isaacllimona/glowie/pcb/panel/glowie_panel.kicad_pcb

## KiCad design pcb/panel/glowie_panel.kicad_pcb (2026-10-28)

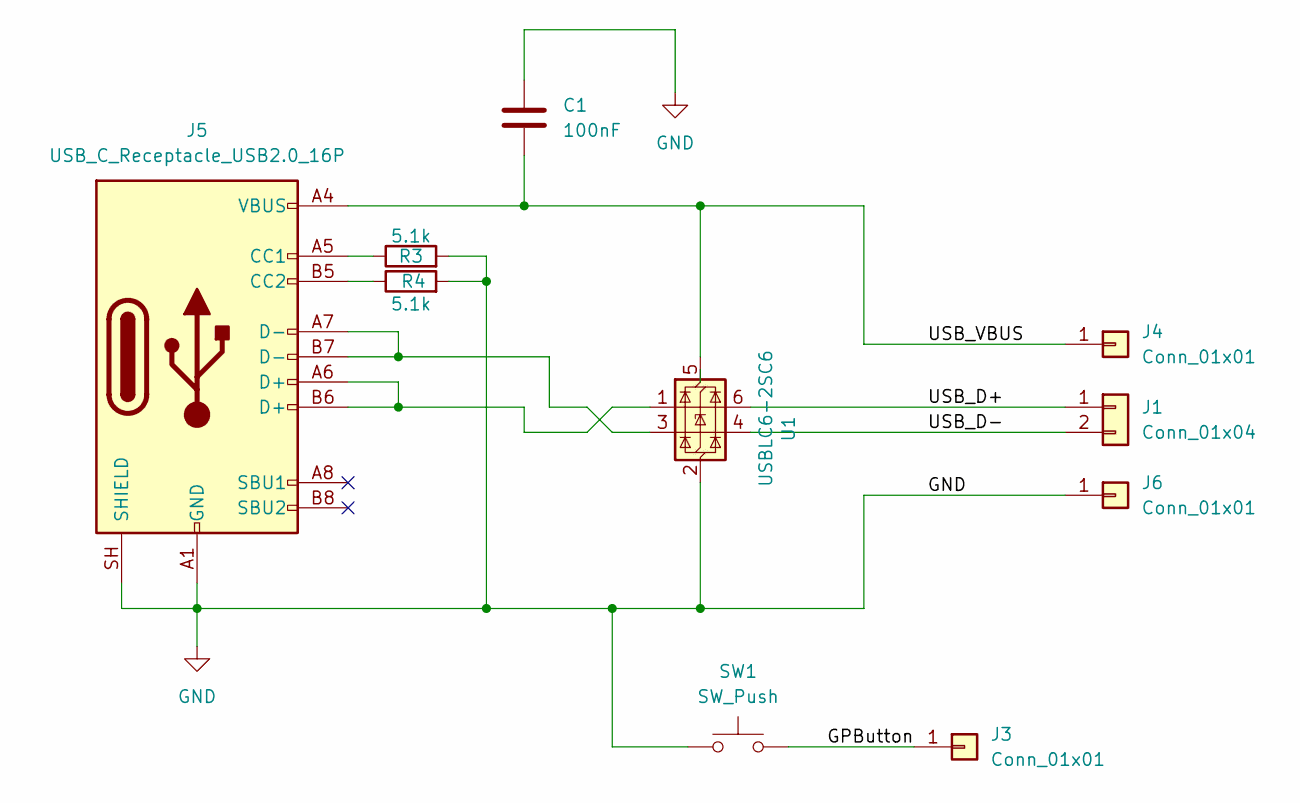
[picture p1: schematic glowie_panel.kicad_sch]

Parts:
C1: 100nF; C_0402_1005Metric
J1: Conn_01x04; usb_data_wire_pads
J3: Conn_01x01; SolderWirePad_1x01_SMD_1.5x3mm
J4, J6: Conn_01x01; th_wire_pad_0.9mm
J5: USB_C_Receptacle_USB2.0_16P; CONN_USB4145-03-0230-C_GCT; MPN USB4220-03-1000-C
R3, R4: 5.1k; R_0402_1005Metric; MPN 0402 5.1k
SW1: SW_Push; TACT_PTS815; MPN PTS815 SJG 250 SMTR LFS
U1: USBLC6-2SC6; SOT-23-6; MPN USBLC6-2SC6

Connections:
/GPButton: J3.1 (Pin_1_1), SW1.2
/USB_D+: J1.1, U1.6 (I/O1)
/USB_D-: J1.2, U1.4 (I/O2)
/USB_VBUS: C1.2, J4.1 (Pin_1_1), J5.A4 (VBUS), J5.A9 (VBUS), J5.B4 (VBUS), J5.B9 (VBUS), U1.5 (VBUS)
GND: C1.1, J5.A1 (GND), J5.A12 (GND), J5.B1 (GND), J5.B12 (GND), J5.SH (SHIELD), J6.1 (Pin_1_1), R3.2, R4.2, SW1.1, U1.2 (GND)
unnamed: J5.A5 (CC1), R3.1
unnamed: J5.B5 (CC2), R4.1
unnamed: J5.A6 (D+), J5.B6 (D+), U1.1 (I/O1)
unnamed: J5.A7 (D-), J5.B7 (D-), U1.3 (I/O2)

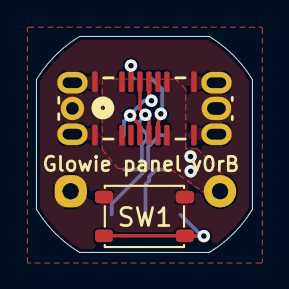
[picture p2: board glowie_panel.kicad_pcb from above]

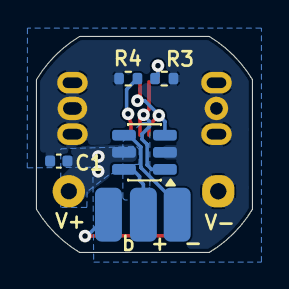
[picture p3: board glowie_panel.kicad_pcb from below]

Board: 2 copper layers, 12.0 x 12.0 mm, 10 parts (8 on the bottom side), 9 nets.
