isaacllimona/glowie/pcb/mainboard/glowie.kicad_pcb

## KiCad design pcb/mainboard/glowie.kicad_pcb (2026-09-04)

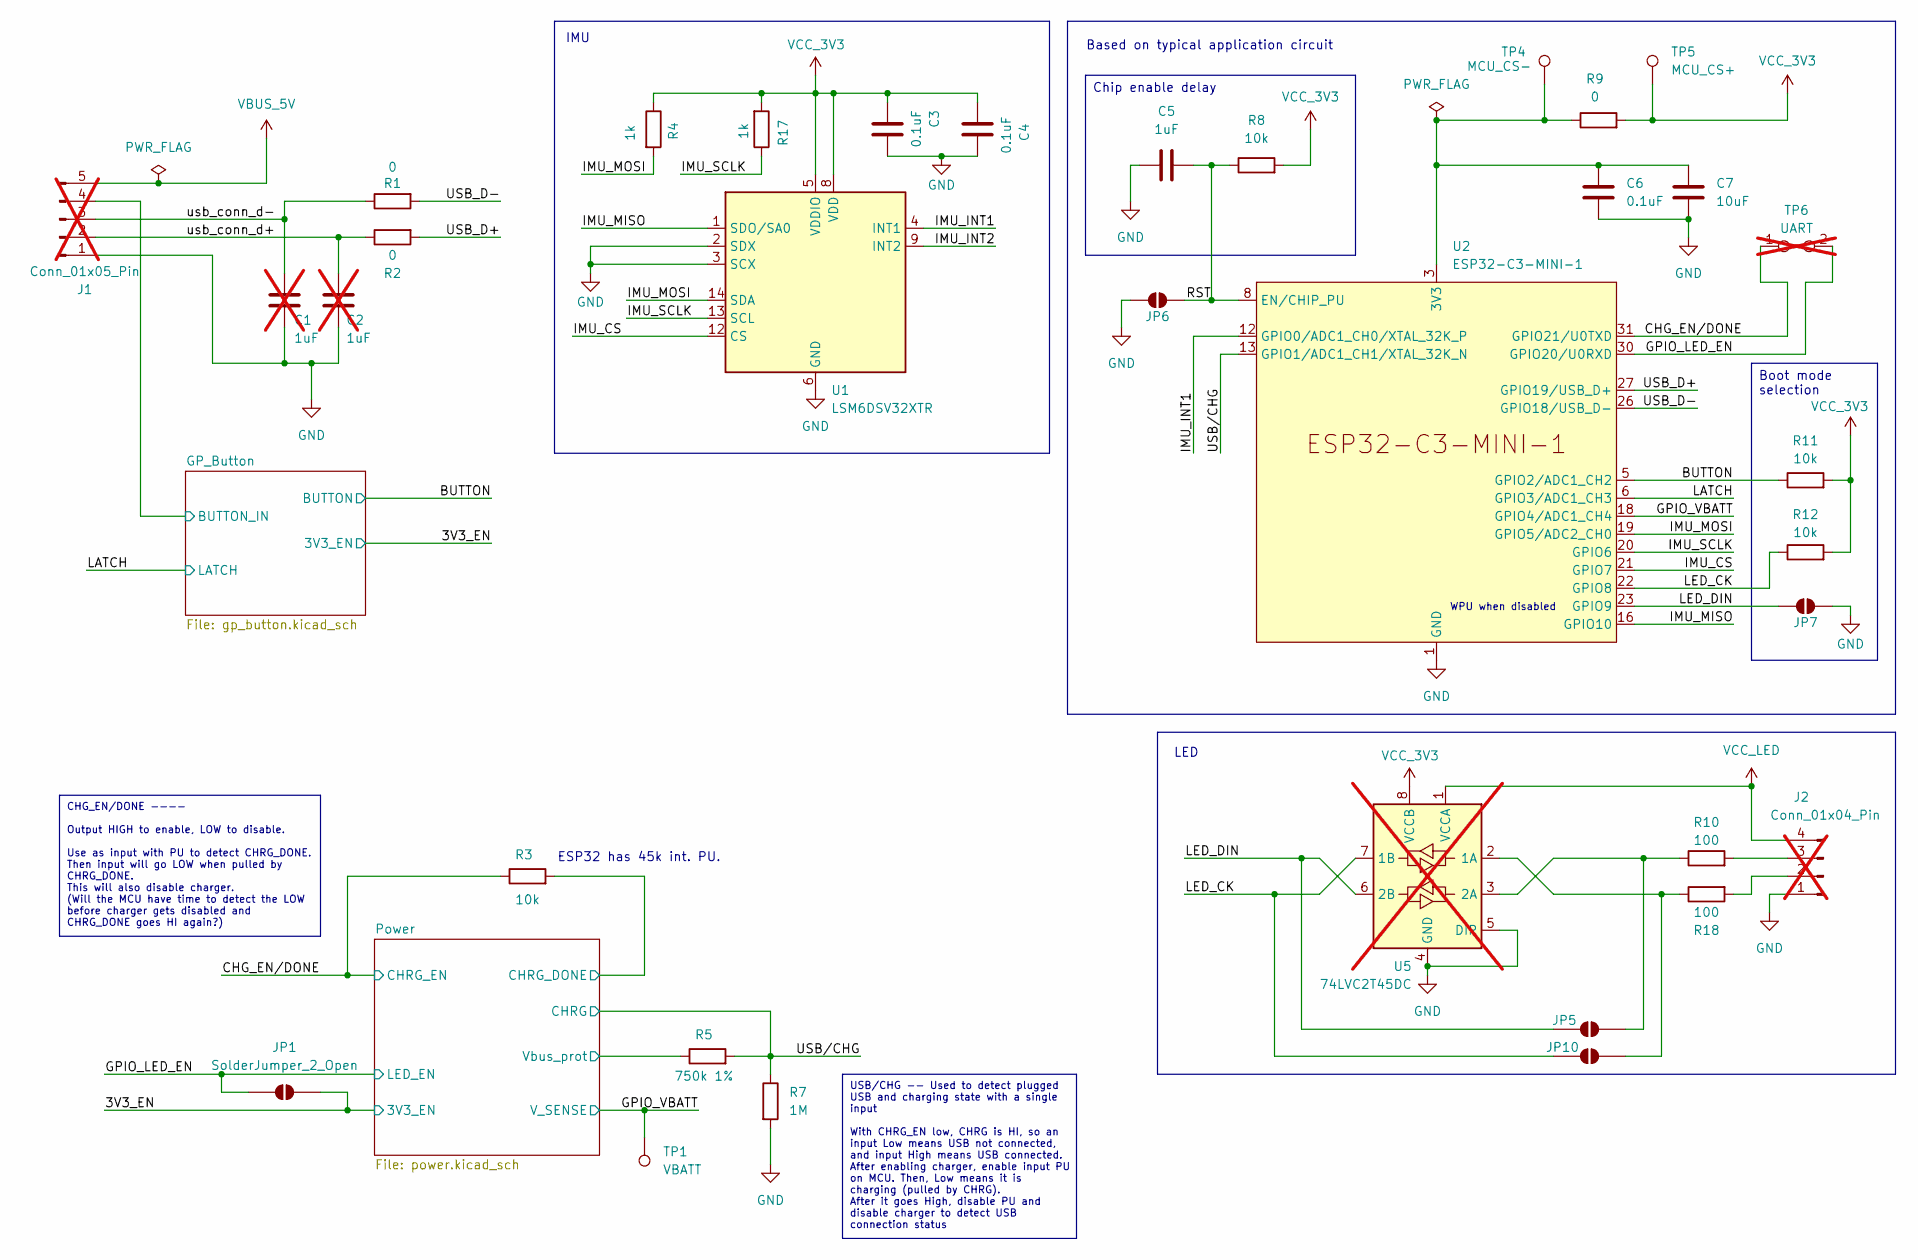
[picture p4: schematic glowie.kicad_sch]

Parts:
C1, C2: 1uF; C_0402_1005Metric; not fitted
C3, C4, C6: 0.1uF; C_0402_1005Metric
C5: 1uF; C_0402_1005Metric
C7: 10uF; C_0402_1005Metric
J1: Conn_01x05_Pin; PinHeader_1x05_P2.00mm_Vertical; not fitted
J2: Conn_01x04_Pin; PinHeader_1x04_P2.00mm_Vertical; not fitted
JP1, JP5, JP10: SolderJumper_2_Open; SolderJumper
JP6, JP7: SolderJumper_2_Open; SolderJumper-2_P1.3mm_Open_RoundedPad1.0x1.5mm
R1, R2: 0; R_0402_1005Metric; MPN 0402 33
R3, R8, R11, R12: 10k; R_0402_1005Metric; MPN 0402 10k
R4, R17: 1k; R_0402_1005Metric_Pad0.72x0.64mm_HandSolder; MPN 0402 1k
R5: 750k 1%; R_0402_1005Metric; MPN 0402 750k
R7: 1M; R_0402_1005Metric; MPN 0402 1M
R9: 0; R_0402_1005Metric_Pad0.72x0.64mm_HandSolder; MPN 0402 10k
R10, R18: 100; R_0402_1005Metric
TP1: VBATT; TestPoint_Pad_D1.0mm
TP4: MCU_CS-; TestPoint_Pad_D1.0mm
TP5: MCU_CS+; TestPoint_Pad_D1.0mm
TP6: UART; PinHeader_1x02_P2.00mm_Vertical; not fitted
U1: LSM6DSV32XTR; LGA-14_3x2.5mm_P0.5mm_LayoutBorder3x4y; MPN LSM6DSV32XTR
U2: ESP32-C3-MINI-1; MPN ESP32-C3-MINI-1
U5: 74LVC2T45DC; VSSOP-8_2.3x2mm_P0.5mm; not fitted

Connections:
/3V3_EN: JP1.1 (A); also elsewhere on the board
/BUTTON: R11.1, U2.5 (GPIO2/ADC1_CH2); also elsewhere on the board
/CHG_EN/DONE: R3.1, TP6.1, U2.31 (GPIO21/U0TXD); also elsewhere on the board
/GPIO_LED_EN: JP1.2 (B), TP6.2, U2.30 (GPIO20/U0RXD); also elsewhere on the board
/GPIO_VBATT: TP1.1 (1_1), U2.18 (GPIO4/ADC1_CH4); also elsewhere on the board
/GP_Button/BUTTON_IN: J1.4; also elsewhere on the board
/IMU_CS: U1.12 (CS), U2.21 (GPIO7)
/IMU_INT1: U1.4 (INT1), U2.12 (GPIO0/ADC1_CH0/XTAL_32K_P)
/IMU_INT2: U1.9 (INT2)
/IMU_MISO: U1.1 (SDO/SA0), U2.16 (GPIO10)
/IMU_MOSI: R4.2, U1.14 (SDA), U2.19 (GPIO5/ADC2_CH0)
/IMU_SCLK: R17.1, U1.13 (SCL), U2.20 (GPIO6)
/LATCH: U2.6 (GPIO3/ADC1_CH3); also elsewhere on the board
/LED_CK: JP10.1 (A), R12.1, U2.22 (GPIO8), U5.7 (1B)
/LED_DIN: JP5.1 (A), JP7.1 (A), U2.23 (GPIO9), U5.6 (2B)
/Power/CHRG_DONE: R3.2; also elsewhere on the board
/Power/Vbus_prot: R5.1; also elsewhere on the board
/RST: C5.2, JP6.2 (B), R8.1, U2.8 (EN/CHIP_PU)
/USB_D+: R2.2, U2.27 (GPIO19/USB_D+)
/USB_D-: R1.2, U2.26 (GPIO18/USB_D-)
/USB/CHG: R5.2, R7.1, U2.13 (GPIO1/ADC1_CH1/XTAL_32K_N); also elsewhere on the board
/usb_conn_d+: C2.2, J1.2, R2.1
/usb_conn_d-: C1.2, J1.3, R1.1
GND: C1.1, C2.1, C3.1, C4.2, C5.1, C6.2, C7.2, J1.1, J2.1, JP6.1 (A), JP7.2 (B), R7.2, U1.2 (SDX), U1.3 (SCX), U1.6 (GND), U1.7 (GND), U2.1 (GND), U2.2 (GND), U2.11 (GND), U2.14 (GND), U2.36 (GND), U2.37 (GND), U2.38 (GND), U2.39 (GND), U2.40 (GND), U2.41 (GND), U2.42 (GND), U2.43 (GND), U2.44 (GND), U2.45 (GND), U2.46 (GND), U2.47 (GND), U2.48 (GND), U2.49 (GND), U2.50 (GND), U2.51 (GND), U2.52 (GND), U2.53 (GND), U5.4 (GND), U5.5 (DIR); also elsewhere on the board
unnamed: J2.2, R18.2
unnamed: J2.3, R10.2
unnamed: JP5.2 (B), R10.1, U5.3 (2A)
unnamed: JP10.2 (B), R18.1, U5.2 (1A)
unnamed: C6.1, C7.1, R9.1, TP4.1 (1_1), U2.3 (3V3)
VBUS_5V: J1.5; also elsewhere on the board
VCC_3V3: C3.2, C4.1, R4.1, R8.2, R9.2, R11.2, R12.2, R17.2, TP5.1 (1_1), U1.5 (VDDIO), U1.8 (VDD), U5.8 (VCCB); also elsewhere on the board
VCC_LED: J2.4, U5.1 (VCCA); also elsewhere on the board

Notes on the sheet:
WPU when disabled
IMU
Based on typical application circuit
LED
ESP32 has 45k int. PU.
Boot mode selection
Chip enable delay
USB/CHG -- Used to detect plugged USB and charging state with a single input With CHRG_EN low, CHRG is HI, so an input Low means USB not connected, and input High means USB connected. After enabling charger, enable input PU on MCU. Then, Low means it is charging (pulled by CHRG). After it goes High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
CHG_EN/DONE ---- Output HIGH to enable, LOW to disable. Use as input with PU to detect CHRG_DONE. Then input will go LOW when pulled by CHRG_DONE. This will also disable charger. (Will the MCU have time to detect the LOW before charger gets disabled and CHRG_DONE goes HI again?)

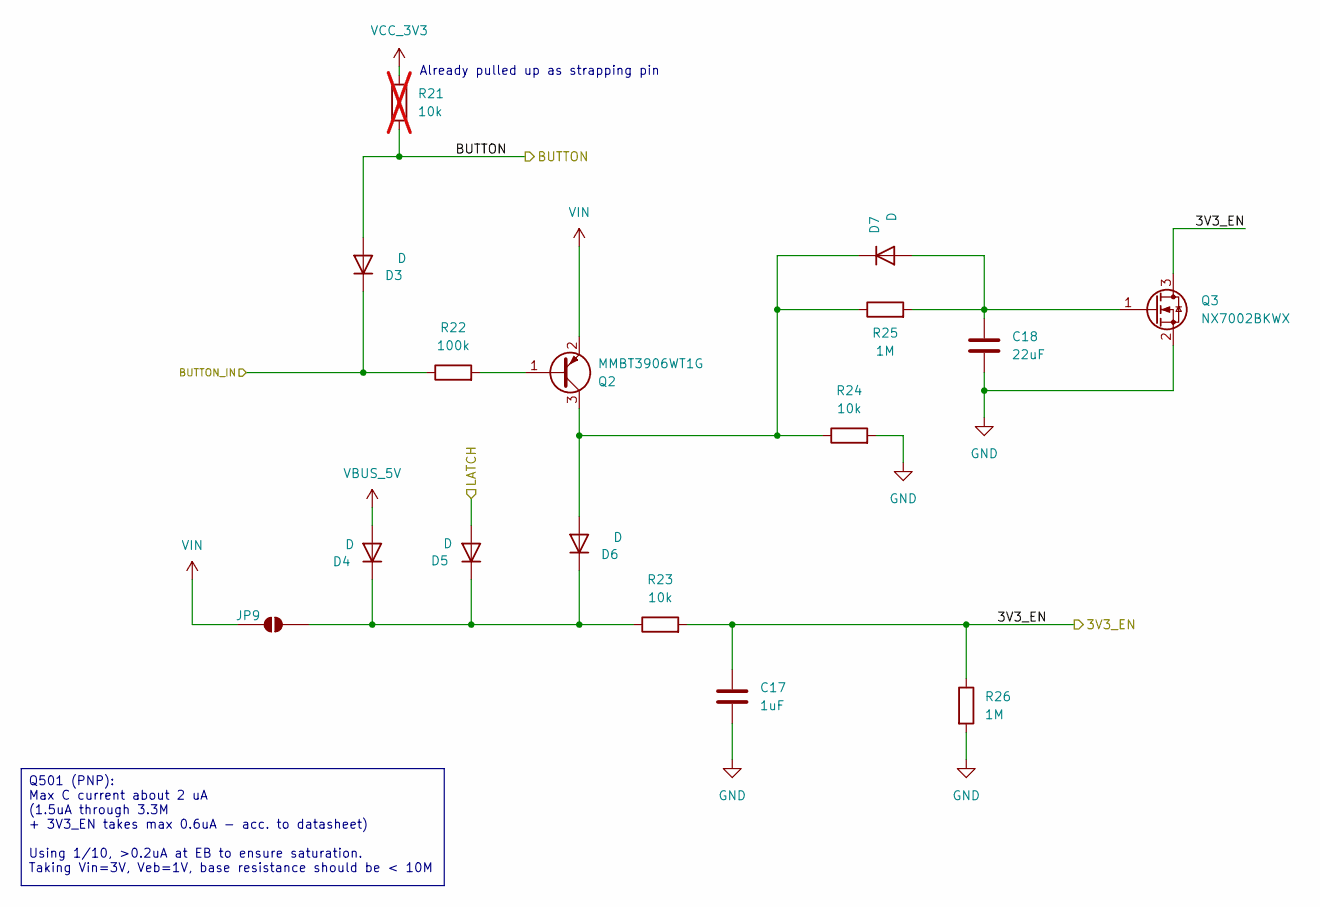
[picture p5: schematic gp_button.kicad_sch]

Parts:
C17: 1uF; C_0402_1005Metric_Pad0.74x0.62mm_HandSolder
C18: 22uF; C_0603_1608Metric
D3, D4, D5, D6, D7: D; D_SOD-882D; MPN 0402
JP9: SolderJumper_2_Open; SolderJumper
Q2: MMBT3906WT1G; SOT-323_SC-70; MPN MMBT3906WT1G
Q3: NX7002BKWX; SOT-323_SC-70
R21: 10k; R_0402_1005Metric; not fitted
R22: 100k; R_0402_1005Metric; MPN 0402 1M
R23, R24: 10k; R_0402_1005Metric; MPN 0402 2M
R25: 1M; R_0402_1005Metric_Pad0.72x0.64mm_HandSolder; MPN 0402 3.3M 1%
R26: 1M; R_0402_1005Metric; MPN 0402 1M

Connections:
/3V3_EN: C17.2, Q3.3 (D), R23.2, R26.1; also elsewhere on the board
/BUTTON: D3.2 (A), R21.2; also elsewhere on the board
/GP_Button/BUTTON_IN: D3.1 (K), R22.1; also elsewhere on the board
/LATCH: D5.2 (A); also elsewhere on the board
GND: C17.1, C18.1, Q3.2 (S), R24.2, R26.2; also elsewhere on the board
unnamed: D4.1 (K), D5.1 (K), D6.1 (K), JP9.2 (B), R23.1
unnamed: D6.2 (A), D7.1 (K), Q2.3 (C), R24.1, R25.1
unnamed: C18.2, D7.2 (A), Q3.1 (G), R25.2
unnamed: Q2.1 (B), R22.2
VBUS_5V: D4.2 (A); also elsewhere on the board
VIN: JP9.1 (A), Q2.2 (E); also elsewhere on the board

Notes on the sheet:
Already pulled up as strapping pin
Q501 (PNP): Max C current about 2 uA (1.5uA through 3.3M + 3V3_EN takes max 0.6uA - acc. to datasheet) Using 1/10, >0.2uA at EB to ensure saturation. Taking Vin=3V, Veb=1V, base resistance should be < 10M

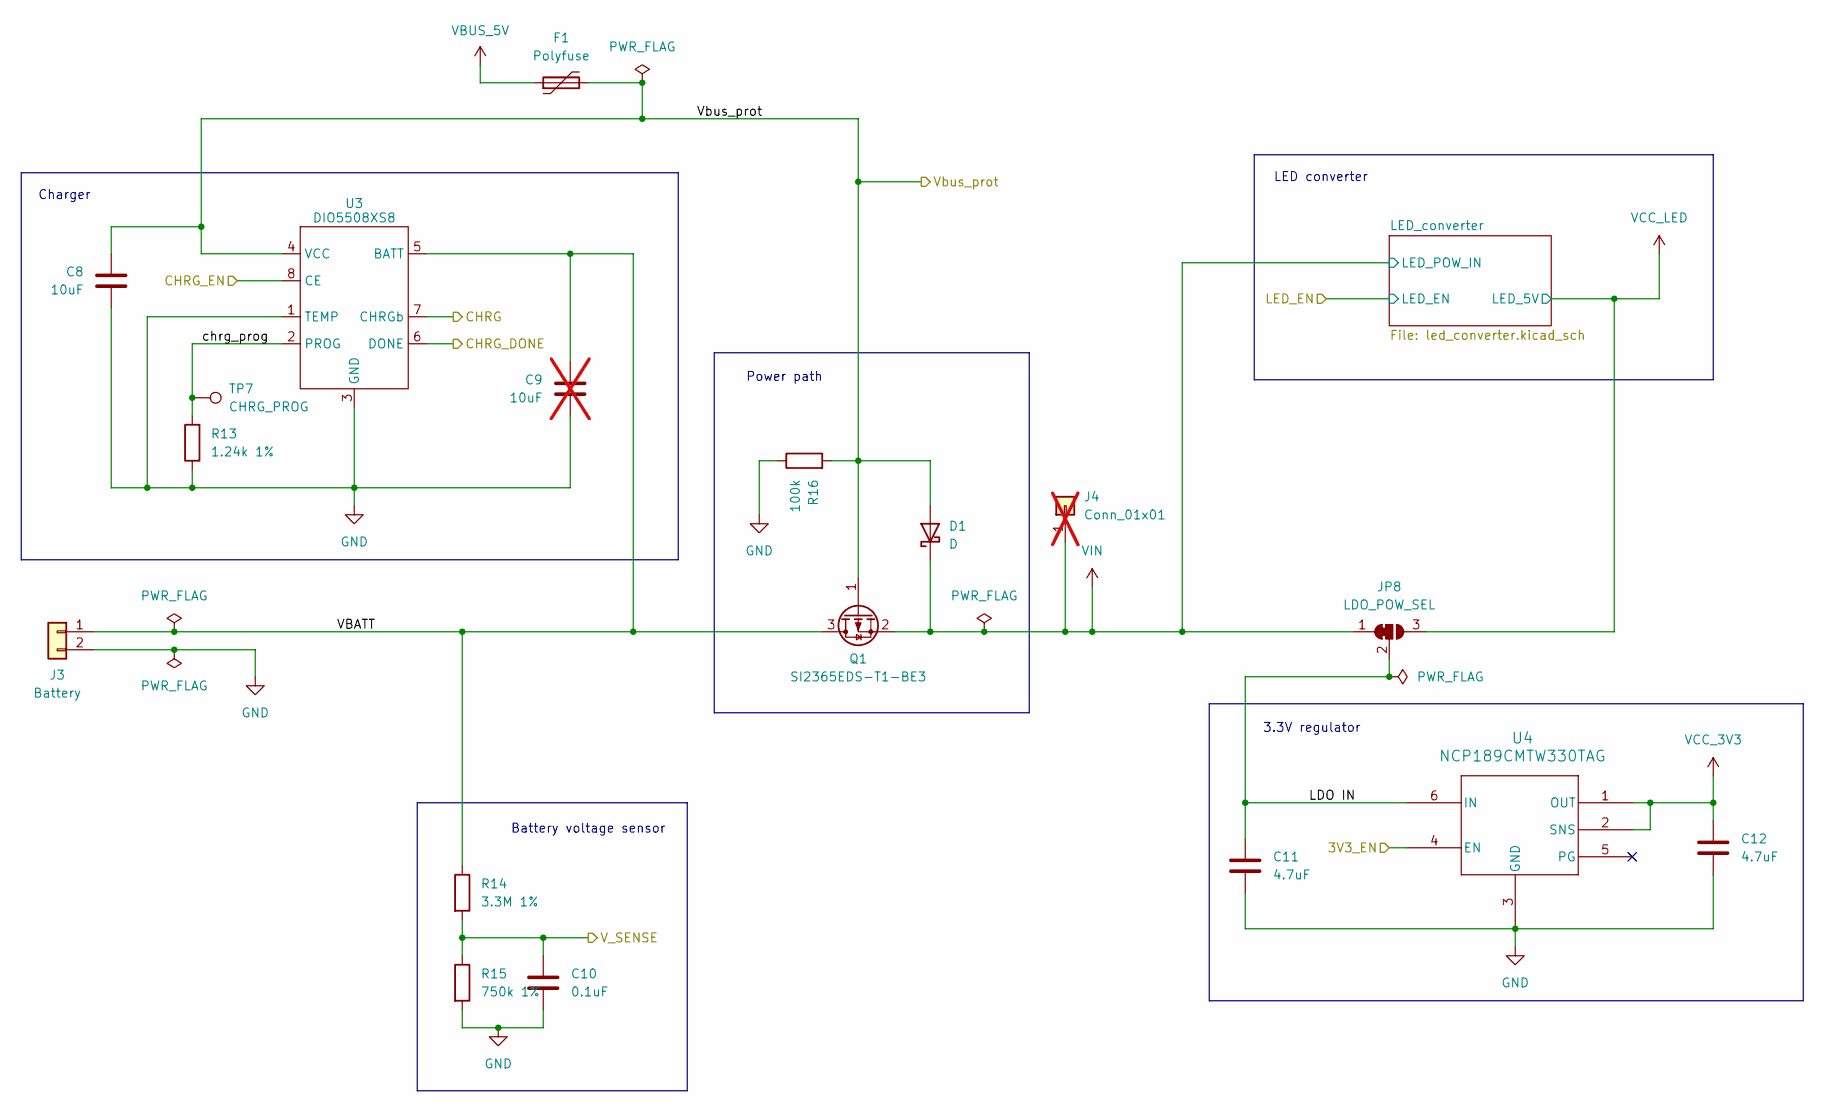
[picture p6: schematic power.kicad_sch]

Parts:
C8: 10uF; C_0402_1005Metric
C9: 10uF; C_0402_1005Metric; not fitted
C10: 0.1uF; C_0402_1005Metric
C11, C12: 4.7uF; C_0402_1005Metric
D1: D; D_SMA; MPN SK34SMA-3G
F1: Polyfuse; Fuse_0603_1608Metric; MPN ERBRE2R00V
J3: Battery; CONN_B02B-PASK-1_JST
J4: Conn_01x01; SolderWire-0.5sqmm_1x01_D0.9mm_OD2.1mm; not fitted
JP8: LDO_POW_SEL; SolderJumper-3_P1.3mm_Bridged12_RoundedPad1.0x1.5mm
Q1: SI2365EDS-T1-BE3; SOT-23; MPN SI2365EDS-T1-BE3
R13: 1.24k 1%; R_0402_1005Metric_Pad0.72x0.64mm_HandSolder; MPN 0402 1.5k
R14: 3.3M 1%; R_0402_1005Metric; MPN 0402 3.3M 1%
R15: 750k 1%; R_0402_1005Metric; MPN 0402 750k
R16: 100k; R_0402_1005Metric; MPN 0402 1M
TP7: CHRG_PROG; TestPoint_Pad_D1.0mm
U3: DIO5508XS8; SOIC-8-1EP_3.9x4.9mm_P1.27mm_EP2.41x3.81mm; MPN DIO5508XS8
U4: NCP189CMTW330TAG; NCP189; MPN NCP189CMTW330TAG

Connections:
/3V3_EN: U4.4 (EN); also elsewhere on the board
/CHG_EN/DONE: U3.8 (CE); also elsewhere on the board
/GPIO_VBATT: C10.1, R14.2, R15.1; also elsewhere on the board
/Power/CHRG_DONE: U3.6 (DONE); also elsewhere on the board
/Power/LDO IN: C11.1, JP8.2 (C), U4.6 (IN)
/Power/VBATT: C9.1, J3.1, Q1.3 (D), R14.1, U3.5 (BATT)
/Power/Vbus_prot: C8.1, D1.2 (A), F1.2, Q1.1 (G), R16.2, U3.4 (VCC); also elsewhere on the board
/Power/chrg_prog: R13.2, TP7.1 (1_1), U3.2 (PROG)
/USB/CHG: U3.7 (CHRGb); also elsewhere on the board
GND: C8.2, C9.2, C10.2, C11.2, C12.2, J3.2, R13.1, R15.2, R16.1, U3.1 (TEMP), U3.3 (GND), U3.9, U4.3 (GND), U4.7 (EPAD); also elsewhere on the board
VBUS_5V: F1.1; also elsewhere on the board
VCC_3V3: C12.1, U4.1 (OUT), U4.2 (SNS); also elsewhere on the board
VCC_LED: JP8.3 (B); also elsewhere on the board
VIN: D1.1 (K), J4.1 (Pin_1_1), JP8.1 (A), Q1.2 (S); also elsewhere on the board

Notes on the sheet:
Battery voltage sensor
3.3V regulator
LED converter
Power path
Charger

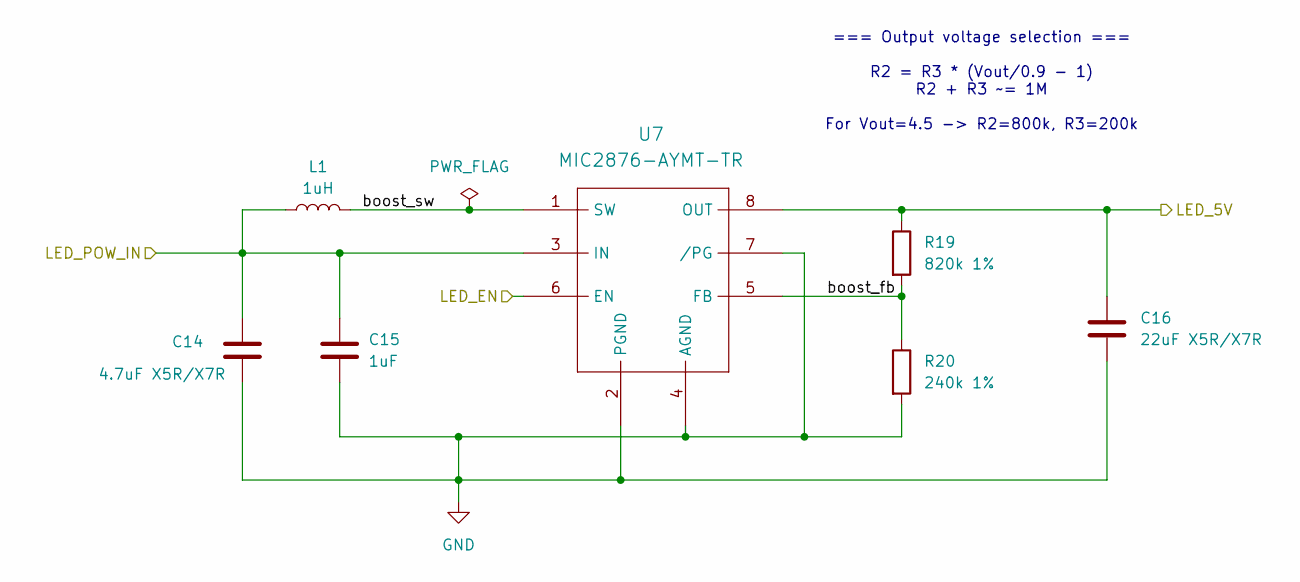
[picture p7: schematic led_converter.kicad_sch]

Parts:
C14: 4.7uF X5R/X7R; C_0402_1005Metric
C15: 1uF; C_0402_1005Metric
C16: 22uF X5R/X7R; C_0603_1608Metric
L1: 1uH; Inductor_SRP3212; MPN SRP3212-1R0M
R19: 820k 1%; R_0402_1005Metric_Pad0.72x0.64mm_HandSolder
R20: 240k 1%; R_0402_1005Metric_Pad0.72x0.64mm_HandSolder
U7: MIC2876-AYMT-TR; UDFN8_2X2_MCH-L; MPN MIC2876-AYMT-TR

Connections:
/GPIO_LED_EN: U7.6 (EN); also elsewhere on the board
/Power/LED_converter/boost_fb: R19.2, R20.1, U7.5 (FB)
/Power/LED_converter/boost_sw: L1.2, U7.1 (SW)
GND: C14.2, C15.2, C16.2, R20.2, U7.2 (PGND), U7.4 (AGND), U7.7 (/PG), U7.9 (AGND); also elsewhere on the board
VCC_LED: C16.1, R19.1, U7.8 (OUT); also elsewhere on the board
VIN: C14.1, C15.1, L1.1, U7.3 (IN); also elsewhere on the board

Notes on the sheet:
=== Output voltage selection === R2 = R3 * (Vout/0.9 - 1) R2 + R3 ~= 1M For Vout=4.5 -> R2=800k, R3=200k

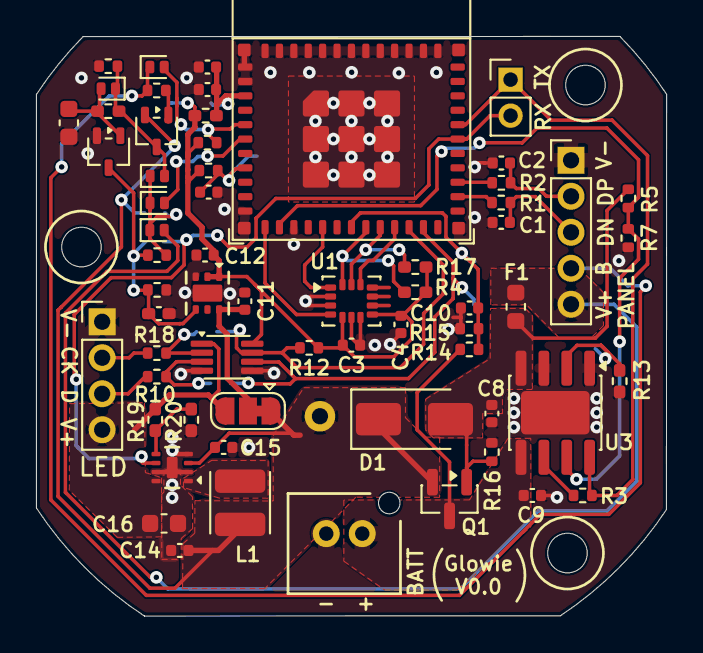
[picture p8: board glowie.kicad_pcb from above]

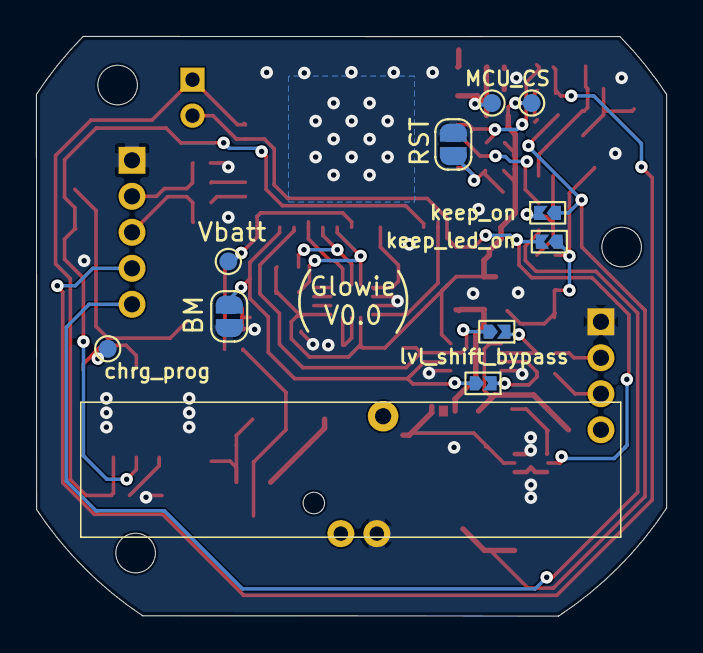
[picture p9: board glowie.kicad_pcb from below]

Board: 2 copper layers, 35.0 x 32.2 mm, 74 parts (10 on the bottom side), 41 nets.
