isaacllimona/glowie/pcb/docs/changelog.md

# Changelog

### panel v0 rev B1
- Finding [1] -> Fix USB protection IC routing

### mainboard v0 rev A2
- Set U2 level shift to DNP
- Swap uc current sense resistor for jumper
- Use 0ohm resistors in USB data lines
- Set boost to 4v
- Finding [6] -> Decrease R23 to 10k, increase C17 to 1uF
- Finding [5] -> Increase R25 to 750k
- Finding [4] -> Decrease powerpath pulldown to 100k

### mainboard v0 rev A1 + panel v0 rev A1
- First version
