isaacllimona/glowie/(commit log)

2026-06-01 Add main glowie PCB
    [glowie.kicad_pcb, glowie.kicad_sch, gp_button.kicad_sch, gp_button_sim.kicad_sch, led_converter.kicad_sch, power.kicad_sch]
2026-06-01 Add panel pcb
    [glowie_panel.kicad_pcb, glowie_panel.kicad_sch]
2026-06-02 Move PCB things to pcb subdirectory
    [glowie.kicad_pcb, glowie.kicad_sch, glowie_panel.kicad_pcb, glowie_panel.kicad_sch, gp_button.kicad_sch, gp_button_sim.kicad_sch, led_converter.kicad_sch, power.kicad_sch]
2026-09-04 mainboard new PCBA revision
    - fix findings
    [glowie.kicad_pcb, glowie.kicad_sch, gp_button.kicad_sch, gp_button_sim.kicad_sch, led_converter.kicad_sch, power.kicad_sch]
2026-09-04 rename PCB folders
    [glowie.kicad_pcb, glowie.kicad_sch, glowie_panel.kicad_pcb, glowie_panel.kicad_sch, gp_button.kicad_sch, gp_button_sim.kicad_sch, led_converter.kicad_sch, power.kicad_sch]
2026-10-27 Fix panel routing
    [glowie_panel.kicad_pcb, glowie_panel.kicad_sch]
2026-10-28 Panel routing improvements
    [glowie_panel.kicad_pcb, glowie_panel.kicad_sch]
